AlexanderEkb/Alarm/Art/lv-n104a.jpg

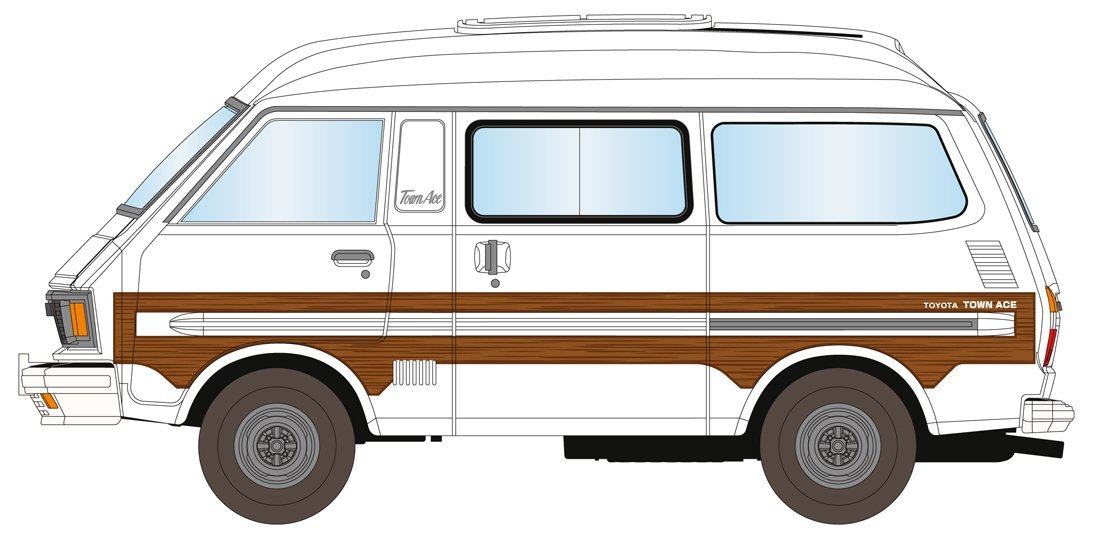
Art/lv-n104a.jpg
