AlexanderEkb/Alarm/Art/2256afcs-960.jpg

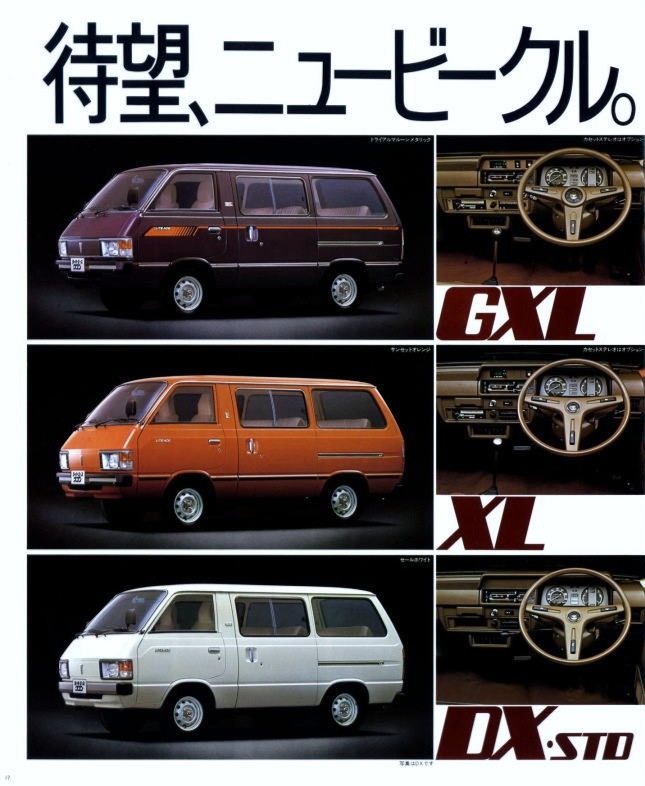
Art/2256afcs-960.jpg
