AlexanderEkb/Alarm/Art/toyota_liteace-26257.jpg

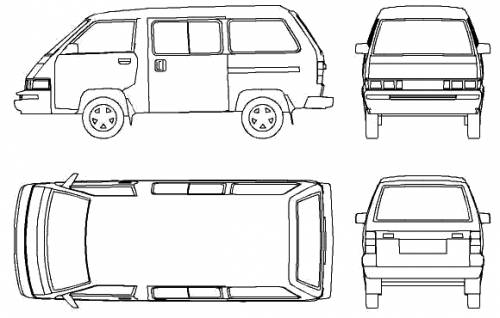
Art/toyota_liteace-26257.jpg
