AlexanderEkb/Alarm/Art/toyota_town_ace_1983-71533.jpg

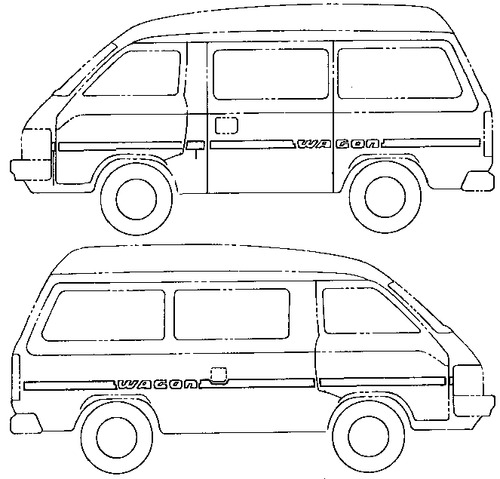
Art/toyota_town_ace_1983-71533.jpg
