AlexanderEkb/Alarm/Art/toyota_townace_van_2014-68481.jpg

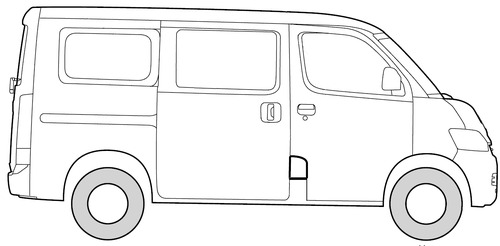
Art/toyota_townace_van_2014-68481.jpg
