AlexanderEkb/Alarm/Base/HW/Project Outputs for Сигнализация/BOM/Bill of Materials-Сигнализация.xls

Sheet: BOM Report
Bill of Materials |  |  | <Parameter Title not found>
Source Data From: |  | Сигнализация.PrjPcb
Project: |  | Сигнализация.PrjPcb
Variant: |  | None
Creation Date: | 11.05.2017 | 8:58:44
Print Date: | 2017-05-11 | 8:58:45
#Column Name Error:Footprint | #Column Name Error:Comment | LibRef | Designator | PartNumber | Quantity
 |  | nRF24L01 + PA + LNA | A1 | nRF24L01+PA+LNA Module | 1
 |  | STM32-1 | A2 | STM32F103 "Blue Pill" Module | 1
 |  | M590E Сборка | A3 | Neoway M590 Assy | 1
 |  | LM2596 Module | A4 | DC-DC Converter Module | 1
 |  | Конденсатор | C1 | T491C227K006AT | 1
 |  | Конденсатор | C2 | T491D477K006AT | 1
 |  | Конденсатор | C3, C4 | CC0603KRX7R7BB104 | 2
 |  | Конденсатор | C5 | CC1206KRX7R9BB104 | 1
 |  | ADM485AR | DD1 | ADM485ARZ-REEL | 1
 |  | TPIC6B595 | DD2 | TPIC6B595DW (SO20W) | 1
 |  | 74HC165 | DD3 | SN74HC165N (DIP16) | 1
 |  | Резистор | R1, R2, R3, R4, R5, R11, R12, R13, R14, R15, R18 |  | 11
 |  | Резистор | R6, R7, R8, R9, R10, R16, R17 | RC1206FR-07100KL | 7
 |  | R0 | RJ6, RJ10, RJ11 | RC1206JR-070RL | 3
 |  | Zener | VD1 | ZMM5226B (ZMM55C-3V3) | 1
 |  | Zener | VD2, VD3, VD4, VD5, VD6, VD7, VD8 | ZMM5229B (ZMM55C-4V3) | 7
 |  | BJT, NPN | VT1 | KSR1002 | 1
 |  | PH-02M(R) | X1, X3 | PH 02MR 2.0mm | 2
 |  | PH-04M(R) | X2 | PH 02M 2.0mm | 1
 |  | MF 2x05 M(R) | X4 | MF 2x05MR | 1
 |  | PH-03M(R) | X5 | PH 02M 2.0mm | 1
 |  | MF 2x03 M(R) | X6 | MF 2x03MR | 1
 |  | PH-04M(R) | X7 | PH 04MR 2.0mm | 1
 |  |  |  |  | 49
Approved |  | Notes

Sheet: Project Information
Project Full Path | D:\Work\Alarm\Base\HW\Ver. 1.1\Сигнализация.PrjPcb
Project Filename | Сигнализация.PrjPcb
Variant Name | None
Data-Source Filename | Сигнализация.PrjPcb
Data-Source Full Path | D:\Work\Alarm\Base\HW\Ver. 1.1\Сигнализация.PrjPcb
Title | <Parameter Title not found>
Total Quantity | 49
Report Time | 8:58:44
Report Date | 11.05.2017
Report Date & Tine | 11.05.2017 8:58:44
Output Name | Bill of Materials
Output Type | BOM_PartType
Output Generator Name | BOM
Output Generator Description | Bill of Materials
