AlexanderEkb/Alarm/FOB/HW/Project Outputs for FOB(3)/BOM/Bill of Materials-FOB(3).xls

Sheet: BOM Report
Bill of Materials |  |  | <Parameter Title not found>
Source Data From: |  | FOB(3).PrjPcb
Project: |  | FOB(3).PrjPcb
Variant: |  | None
Creation Date: | 23.11.2017 | 22:41:56
Print Date: | 2017-11-23 | 22:46:23
Designator | PartNumber |  |  | Quantity
BQ1 | CST-931RP-A |  |  | 1
C1, C2 | CC0402JRNPO9BN220 |  |  | 2
C3 | GRM155R71H222KA01D |  |  | 1
C4 | CC0402BRNPO9BN4R7 |  |  | 1
C5 | CC0402CRNPO9BN1R5 |  |  | 1
C6 | CC0402BRNPO9BNR50 |  |  | 1
C7 | CC0402KRX7R7BB333 |  |  | 1
C8 | CC0402JRNPO9BN102 |  |  | 1
C9 | CC0402KRX7R9BB103 |  |  | 1
C10, C12, C14 | GRM155R61A225KE95D |  |  | 3
C11, C13 | CC0402KRX5R5BB105 |  |  | 2
C15 | GRM155R60J475ME87D |  |  | 1
C16, C18, C19, C20, C21 | CC0402KRX7R7BB104 |  |  | 5
C17 | T491A336K006AT |  |  | 1
DA1 | nRF24L01+ |  |  | 1
DA2 | NCP1400A |  |  | 1
DD1 | STM32F051K8U6 |  |  | 1
GB1, SW1 | Custom |  |  | 2
HG1 | SSD1306 OLED Module |  |  | 1
L1 | LQW15AN8N2G00D |  |  | 1
L2 | LQG15HS27NJ02D |  |  | 1
L3 | LQG15HN3N9S02D |  |  | 1
L4 | VLCF4028T-220MR72-2 |  |  | 1
R1 | RC0402FR-071ML |  |  | 1
R2 | RC0402FR-0722KL |  |  | 1
R3, R4, R6, R7 | RC0402FR-071KL |  |  | 4
R5 | RC0402FR-07390KL |  |  | 1
R8, R9 | RC0402JR-070RL |  |  | 2
VD1 | STPS0520Z |  |  | 1
X1 | PLLD1.27-80 (2X40) SMD |  |  | 1
X2 | PBD1.27-12 (2X06) SMD |  |  | 1
ZQ1 | 16000 KHz HC-49/US |  |  | 1
 |  |  |  | 45
Approved |  | Notes

Sheet: Project Information
Project Full Path | D:\Work\Alarm\FOB\HW\Брелок-3\FOB(3).PrjPcb
Project Filename | FOB(3).PrjPcb
Variant Name | None
Data-Source Filename | FOB(3).PrjPcb
Data-Source Full Path | D:\Work\Alarm\FOB\HW\Брелок-3\FOB(3).PrjPcb
Title | <Parameter Title not found>
Total Quantity | 45
Report Time | 22:41:56
Report Date | 23.11.2017
Report Date & Tine | 23.11.2017 22:41:56
Output Name | Bill of Materials
Output Type | BOM_PartType
Output Generator Name | BOM
Output Generator Description | Bill of Materials
