AlexanderEkb/Alarm/FOB/Enclosure/TopBoard/Top.step

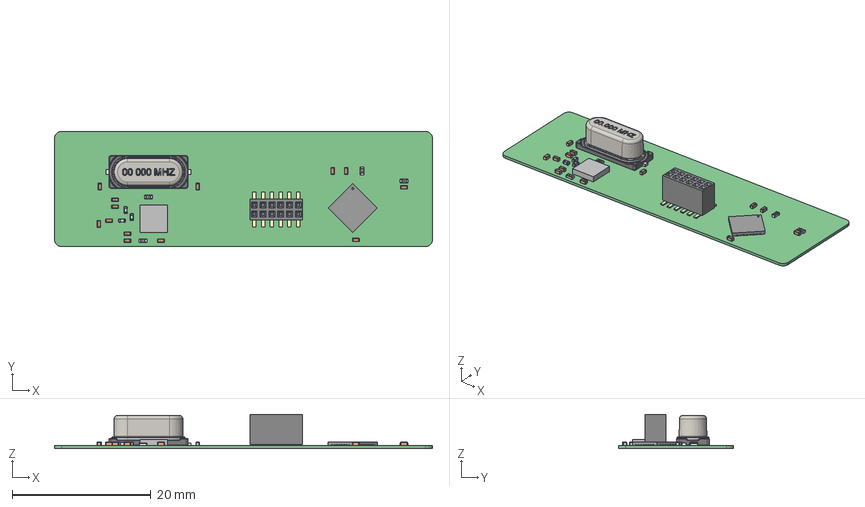
[picture p8: CAD file, 2018-03-03]
FOB/Enclosure/TopBoard/Top.step
54.5 x 16.6 x 4.91 mm
Board
Extruded
User_Library-PBD1_27-12-S
User_Library-UFQFPN32
User_Library-0402(1005M)_Cap x 13
User_Library-RES_1005-0402 x 4
User_Library-HC-49S
User_Library-INDC1005X___ x 3
