AlexanderEkb/Alarm/FOB/HW/Project Outputs for FOB(3)/FOB Schematics.PDF

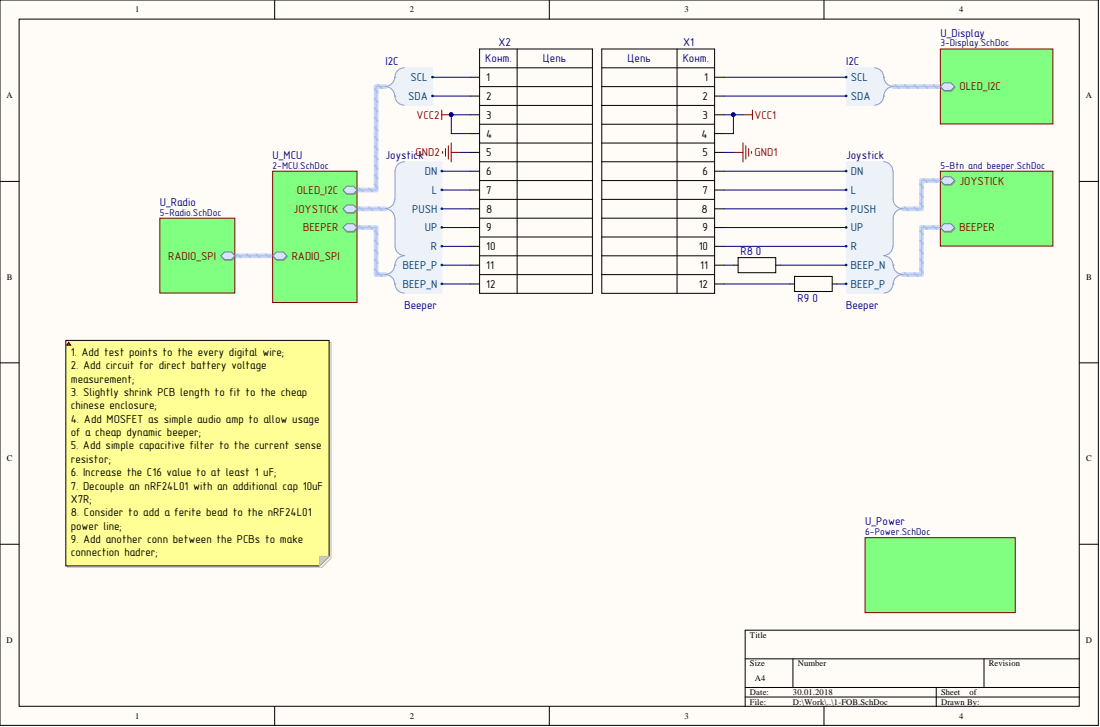
[picture p9: page 1]

5-Btn and beeper.SchDoc
JOYSTICK

1. Add test points to the every digital wire;
2. Add circuit for direct battery voltage
measurement;
3. Slightly shrink PCB length to fit to the cheap
chinese enclosure;
4. Add MOSFET as simple audio amp to allow usage
of a cheap dynamic beeper;
5. Add simple capacitive filter to the current sense
resistor;
6. Increase the C16 value to at least 1 uF;
7. Decouple an nRF24L01 with an additional cap 10uF
8. Consider to add a ferite bead to the nRF24L01
power line;
9. Add another conn between the PCBs to make
connection hadrer;

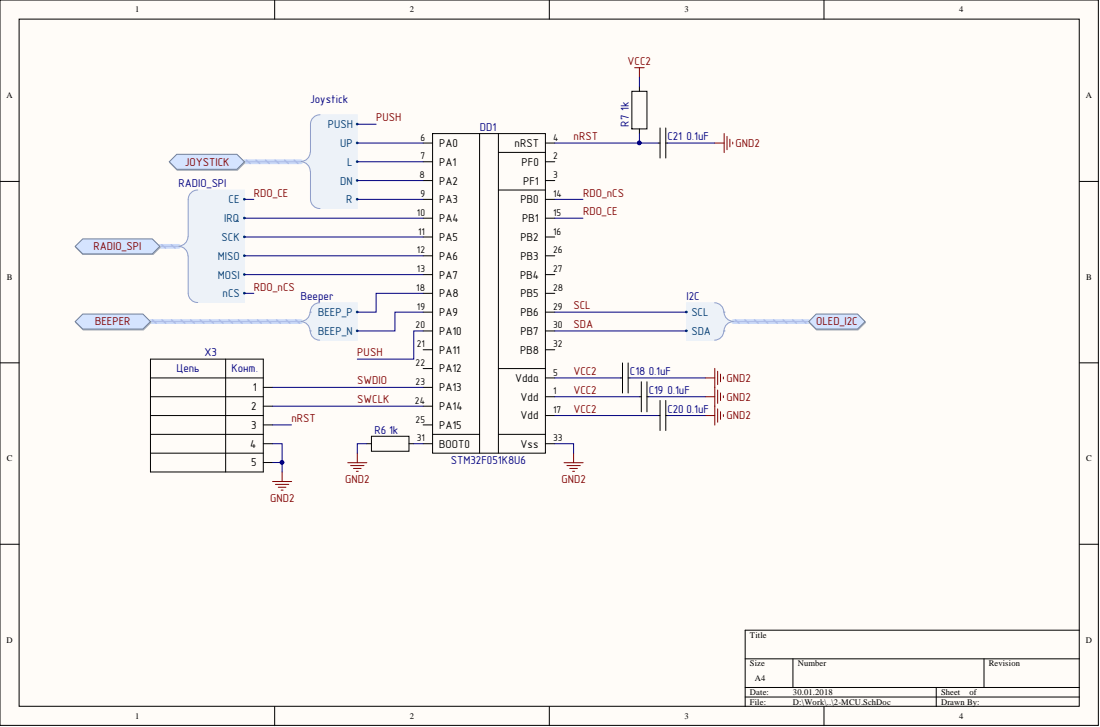
[picture p10: page 2]

PUSH

Цепь | Конт. | SWDIO

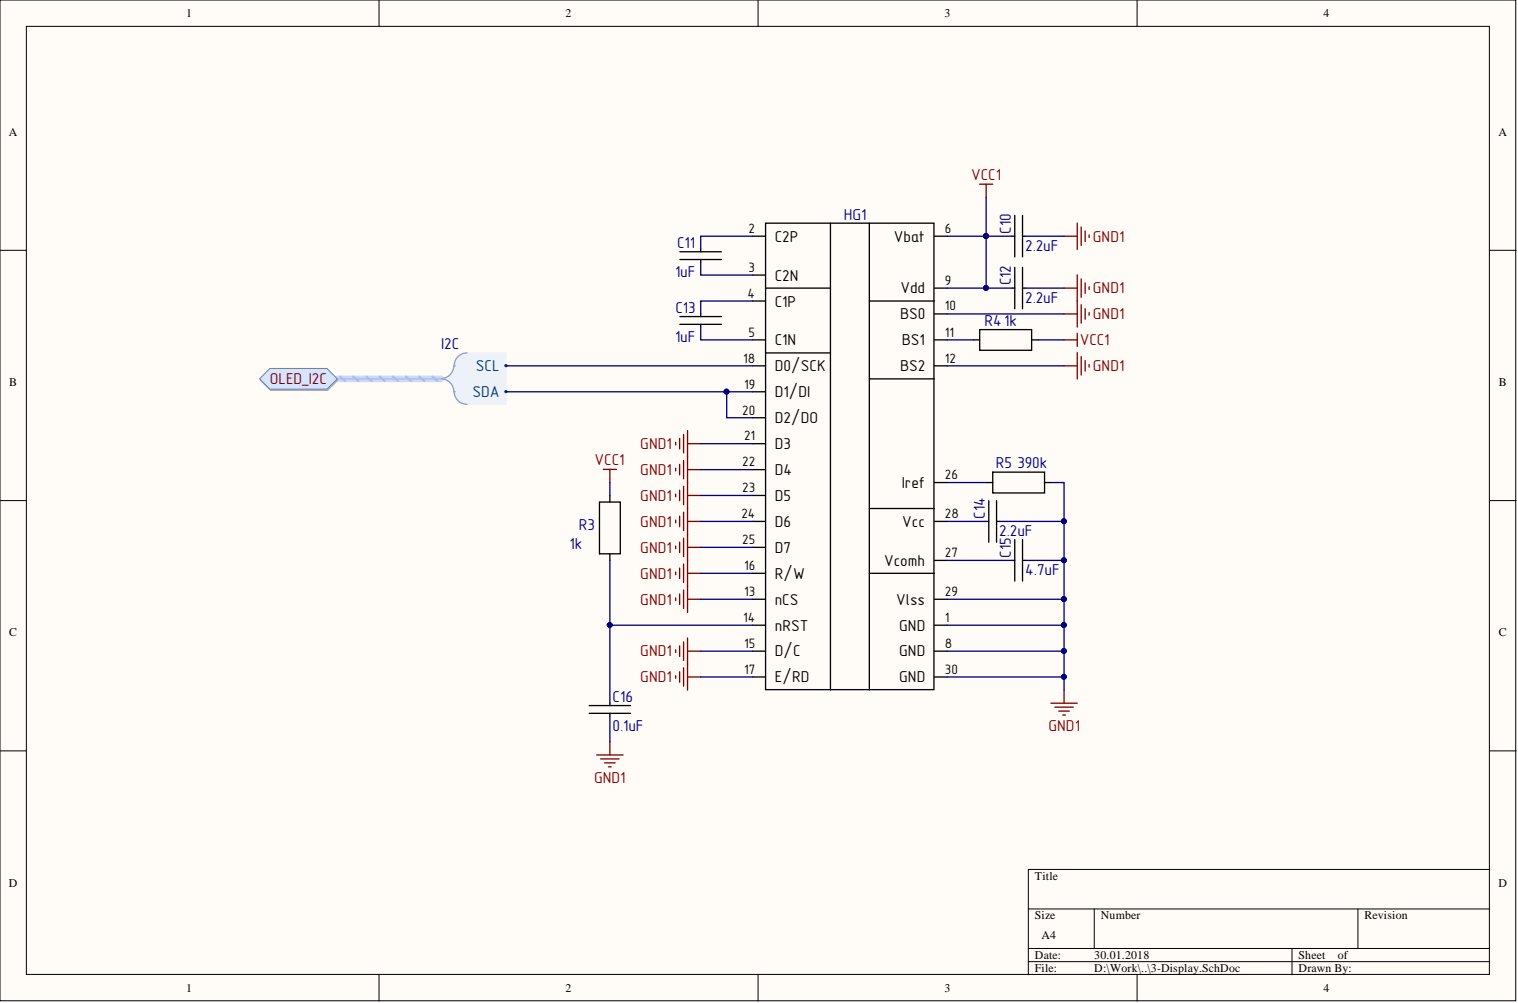
[picture p11: page 3]

C2P C2N | Vbat Vdd

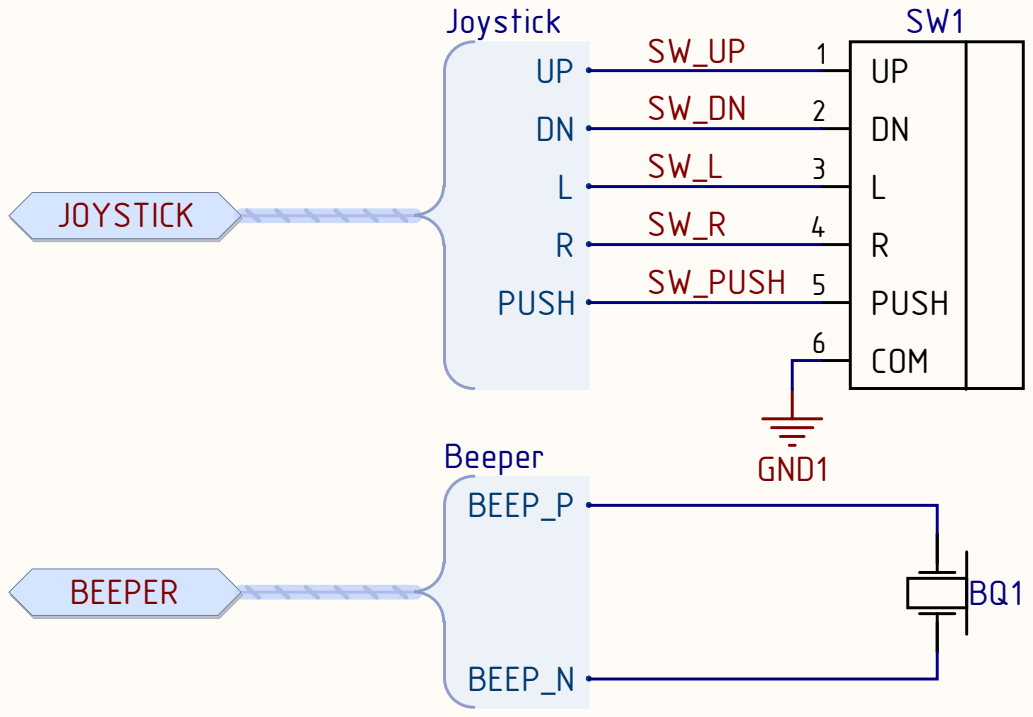
[picture p12: page 4]

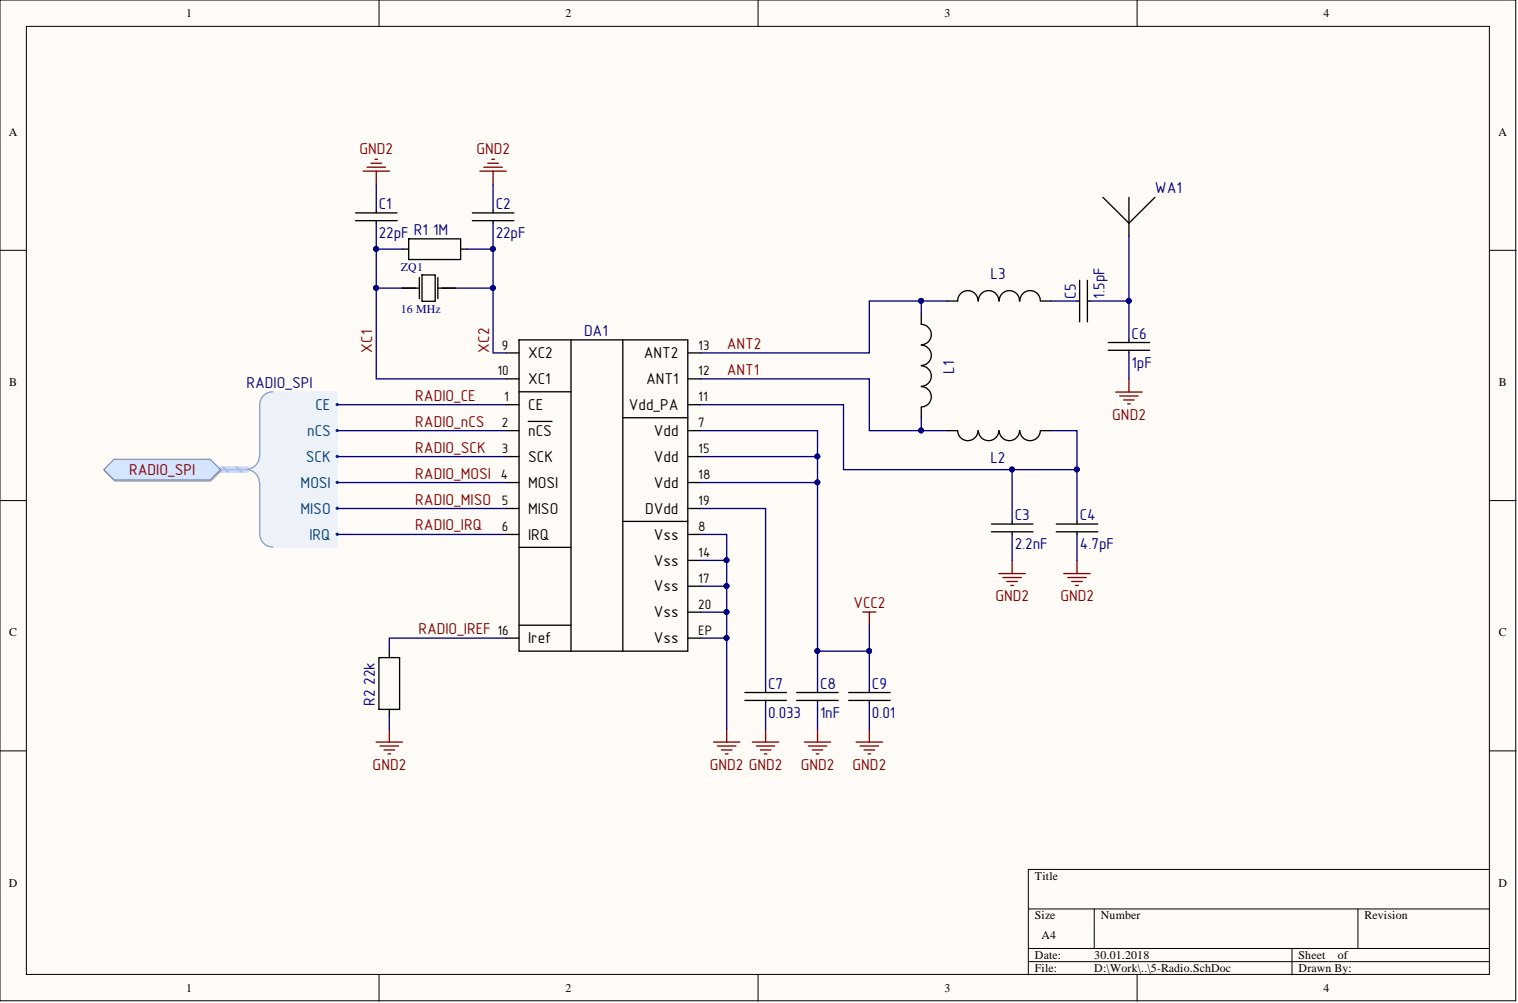
[picture p13: page 5]

1 4
1 7

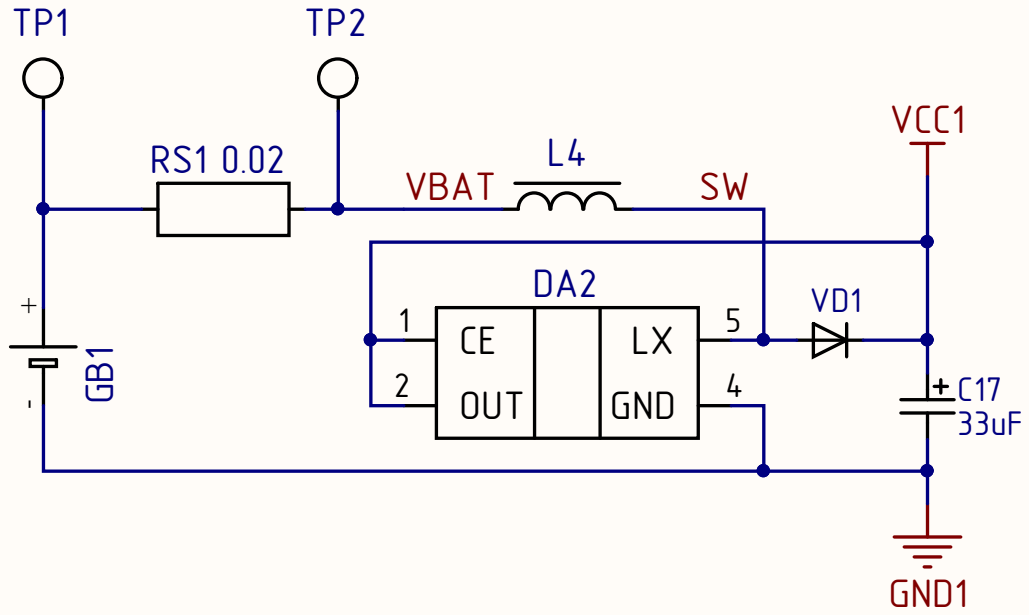
[picture p14: page 6]
