AlexanderEkb/Alarm/Base/HW/Project Outputs for Сигнализация/Основной блок.PDF

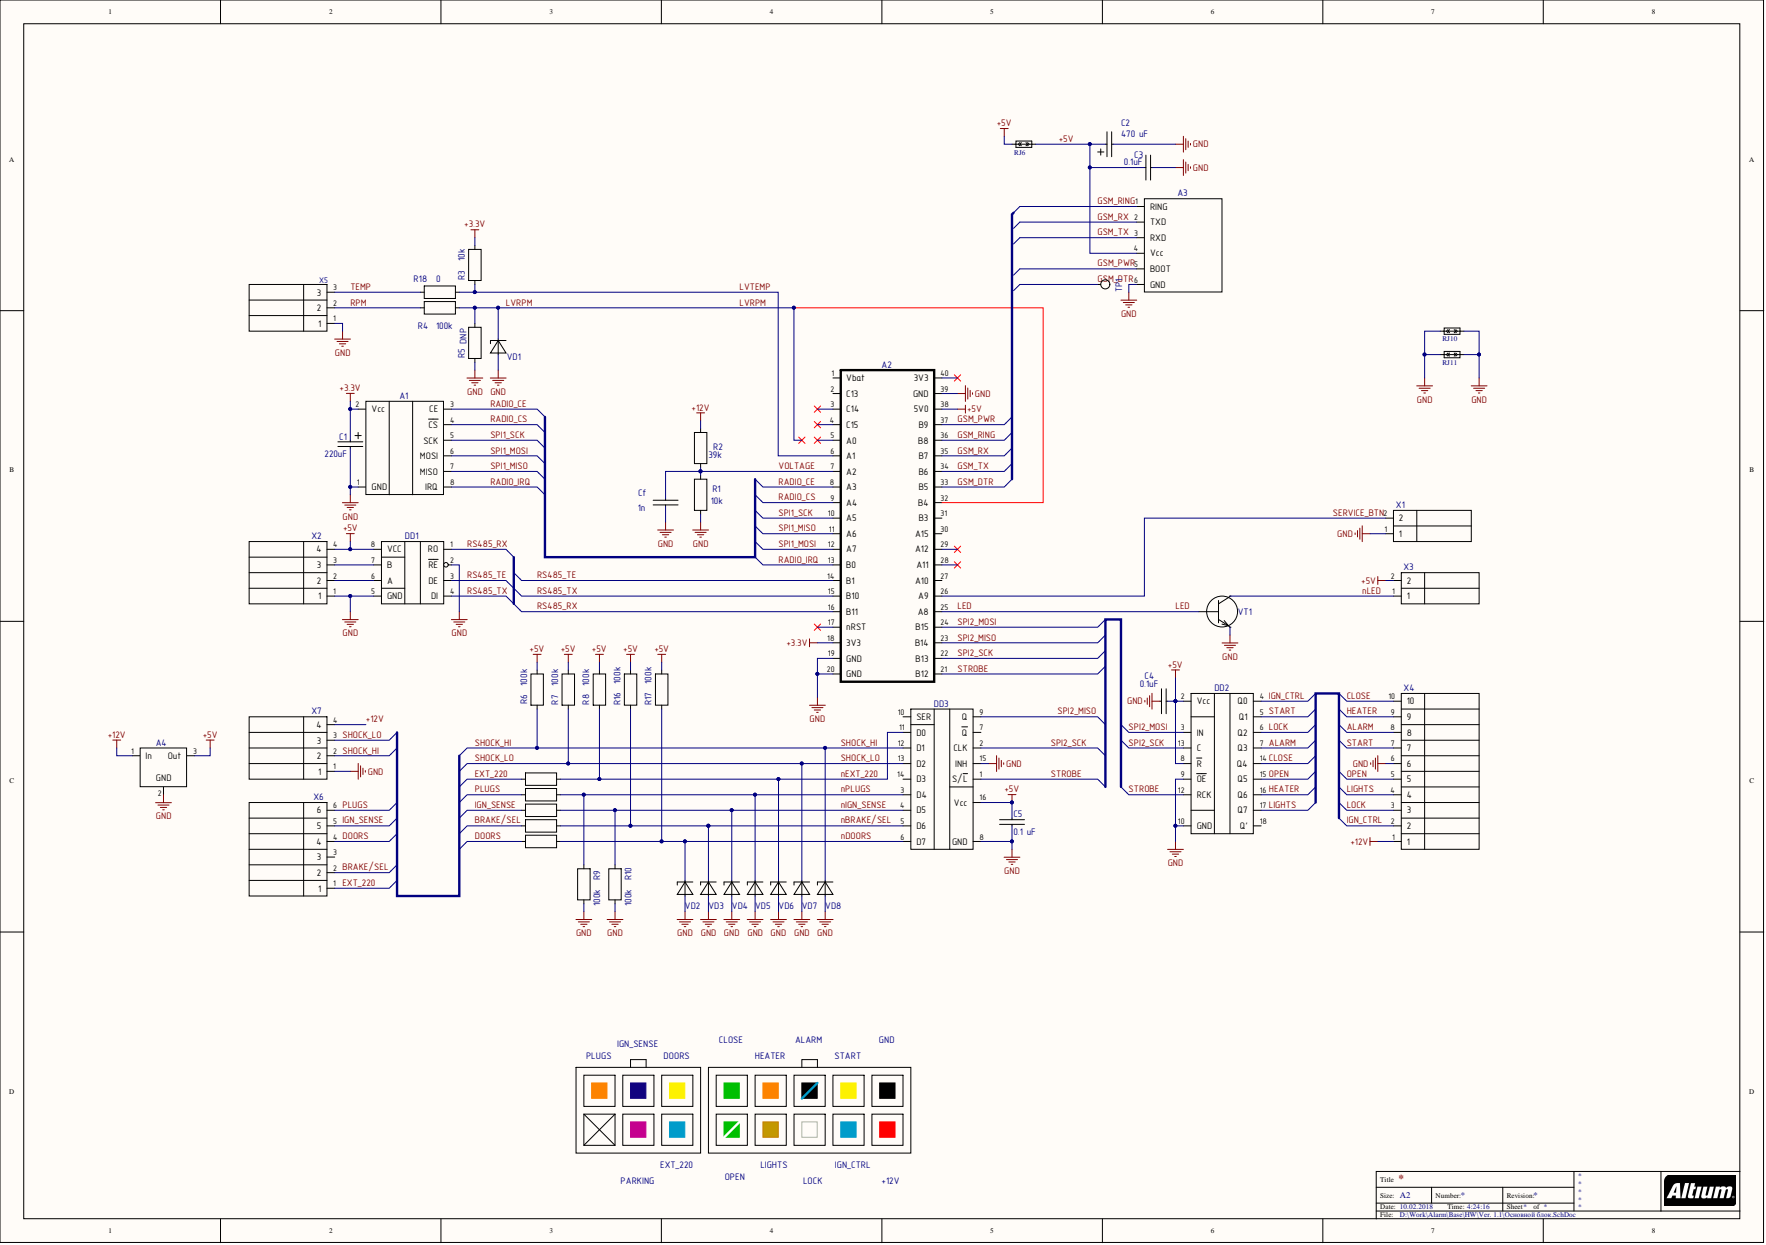
[picture p15: page 1]

1 | RADIO_CE | VD1 +12V | A2

RADIO_CE RADIO_CS

5 5
4 4
3 3

GND GND GND GND GND GND GND

Title * | * * * * *

Size: A2 | Number: * | Revision: *
Date: 10.02.2018 Time: 4:24:16 | | Sheet * of *

D:\Work\Alarm\Base\HW\Ver. 1.1\Основной блок.SchDoc
File:
