AlexanderEkb/Alarm/(list of files, drawings)

Other design files:
Base/HW/Основной блок.SchDoc
Base/HW/Сигнализация.PrjPcb
FOB/HW/1-FOB.SchDoc
FOB/HW/2-MCU.SchDoc
FOB/HW/3-Display.SchDoc
FOB/HW/5-Btn and beeper.SchDoc
FOB/HW/5-Radio.SchDoc
FOB/HW/6-Power.SchDoc
FOB/HW/FOB - lower.PcbDoc
FOB/HW/FOB - upper.PcbDoc
FOB/HW/FOB(3).PrjPcb
Power/Power.PcbDoc
Power/Power.PrjPcb
Power/Power.SchDoc
