AlexanderEkb/Alarm/FOB/SW/FOB_3/Keyfob/Src/main.c

/**
  ******************************************************************************
  * File Name          : main.c
  * Description        : Main program body
  ******************************************************************************
  * This notice applies to any and all portions of this file
  * that are not between comment pairs USER CODE BEGIN and
  * USER CODE END. Other portions of this file, whether
  * inserted by the user or by software development tools
  * are owned by their respective copyright owners.
  *
  * Copyright (c) 2017 STMicroelectronics International N.V.
  * All rights reserved.
  *
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
  ******************************************************************************
  */

/* Includes ------------------------------------------------------------------*/
#include "main.h"
#include "stm32f0xx_hal.h"
#include "cmsis_os.h"

/* USER CODE BEGIN Includes */
#include "power.h"
#include "sound.h"
#include "protocol.h"
#include "radio.h"
#include "ui.h"
#include "dispatcher.h"

/* USER CODE END Includes */


osThreadId RADIOHandle;
osThreadId UIHandle;
osThreadId DISPHandle;
osThreadId SOUNDHandle;

/* USER CODE BEGIN PV */

/* USER CODE END PV */

void SystemClock_Config(void);
static void MX_GPIO_Init(void);
static void MX_I2C1_Init(void);
static void MX_SPI1_Init(void);
static void MX_TIM1_Init(void);
static void MX_ADC_Init(void);
static void MX_RTC_Init(void);
void Radio_Task(void const * argument);
void UI_Task(void const * argument);
static void MX_NVIC_Init(void);

/* USER CODE BEGIN PFP */

/* USER CODE END PFP */

int main(void)
{

    /* USER CODE BEGIN 1 */
    /* Set up low power mode used. */
    MX_GPIO_Init();
    Power_Init();
    /* USER CODE END 1 */

    /* MCU Configuration----------------------------------------------------------*/

    /* Reset of all peripherals, Initializes the Flash interface and the Systick. */
    HAL_Init();

    /* Configure the system clock */
    SystemClock_Config();

    /* USER CODE BEGIN SysInit */

    PWR->CR |= PWR_CR_DBP;
    RCC->CSR |= RCC_CSR_LSION;

    /* USER CODE END SysInit */

    /* Initialize all configured peripherals */
//    MX_GPIO_Init();
    MX_I2C1_Init();
    MX_SPI1_Init();
    MX_TIM1_Init();
    MX_ADC_Init();
    MX_RTC_Init();

    /* Initialize interrupts */
    MX_NVIC_Init();

    /* USER CODE BEGIN 2 */
    Power_InitSettings(0, 0);
    Radio_Init();
    Sound_Init();
    Power_InitIWDG();
    /* USER CODE END 2 */

    /* USER CODE BEGIN RTOS_MUTEX */
    /* add mutexes, ... */
    /* USER CODE END RTOS_MUTEX */

    /* USER CODE BEGIN RTOS_SEMAPHORES */
    /* add semaphores, ... */
    /* USER CODE END RTOS_SEMAPHORES */

    /* USER CODE BEGIN RTOS_TIMERS */
    /* start timers, add new ones, ... */
    /* USER CODE END RTOS_TIMERS */

    /* Create the thread(s) */
    /* definition and creation of RADIO */
    osThreadDef(RADIO, Radio_Task, osPriorityRealtime, 0, 256);
    RADIOHandle = osThreadCreate(osThread(RADIO), NULL);

    /* definition and creation of UI */
    osThreadDef(UI, UI_Task, osPriorityBelowNormal, 0, 256);
    UIHandle = osThreadCreate(osThread(UI), NULL);

    /* definition and creation of DISPATCHER */
    osThreadDef(DISP, Dispatcher_Task, osPriorityLow, 0, 256);
    DISPHandle = osThreadCreate(osThread(DISP), NULL);

    /* definition and creation of SOUND */
    osThreadDef(SOUND, Sound_Task, osPriorityNormal, 0, 128);
    SOUNDHandle = osThreadCreate(osThread(SOUND), NULL);

    /* USER CODE BEGIN RTOS_THREADS */
    /* add threads, ... */
    /* USER CODE END RTOS_THREADS */

    /* USER CODE BEGIN RTOS_QUEUES */
    UI_Init();
    /* USER CODE END RTOS_QUEUES */


    /* Start scheduler */
    osKernelStart();

    /* We should never get here as control is now taken by the scheduler */

    /* Infinite loop */
    /* USER CODE BEGIN WHILE */
    while (1)
    {
    /* USER CODE END WHILE */

    /* USER CODE BEGIN 3 */
        vTaskDelay(1);
    }
    /* USER CODE END 3 */

}

/** System Clock Configuration
*/
void SystemClock_Config(void)
{

  LL_FLASH_SetLatency(LL_FLASH_LATENCY_0);

  if(LL_FLASH_GetLatency() != LL_FLASH_LATENCY_0)
  {
  Error_Handler();
  }
  LL_RCC_HSI_Enable();

   /* Wait till HSI is ready */
  while(LL_RCC_HSI_IsReady() != 1)
  {

  }
  LL_RCC_HSI_SetCalibTrimming(16);

  LL_RCC_HSI14_Enable();

   /* Wait till HSI14 is ready */
  while(LL_RCC_HSI14_IsReady() != 1)
  {

  }
  LL_RCC_HSI14_SetCalibTrimming(16);

  LL_RCC_LSI_Enable();

   /* Wait till LSI is ready */
  while(LL_RCC_LSI_IsReady() != 1)
  {

  }
  LL_PWR_EnableBkUpAccess();

  //LL_RCC_ForceBackupDomainReset();

  //LL_RCC_ReleaseBackupDomainReset();

  LL_RCC_SetRTCClockSource(LL_RCC_RTC_CLKSOURCE_LSI);

  LL_RCC_EnableRTC();

  LL_RCC_SetAHBPrescaler(LL_RCC_SYSCLK_DIV_1);

  LL_RCC_SetAPB1Prescaler(LL_RCC_APB1_DIV_1);

  LL_RCC_SetSysClkSource(LL_RCC_SYS_CLKSOURCE_HSI);

   /* Wait till System clock is ready */
  while(LL_RCC_GetSysClkSource() != LL_RCC_SYS_CLKSOURCE_STATUS_HSI)
  {

  }
  LL_Init1msTick(8000000);

  LL_SYSTICK_SetClkSource(LL_SYSTICK_CLKSOURCE_HCLK);

  LL_SetSystemCoreClock(8000000);

  LL_RCC_HSI14_EnableADCControl();

  LL_RCC_SetI2CClockSource(LL_RCC_I2C1_CLKSOURCE_SYSCLK);

  /* SysTick_IRQn interrupt configuration */
  NVIC_SetPriority(SysTick_IRQn, 3);
}

/** NVIC Configuration
*/
static void MX_NVIC_Init(void)
{
  /* SPI1_IRQn interrupt configuration */
  NVIC_SetPriority(SPI1_IRQn, 3);
  NVIC_EnableIRQ(SPI1_IRQn);
  /* EXTI4_15_IRQn interrupt configuration */
  NVIC_SetPriority(EXTI4_15_IRQn, 3);
  NVIC_EnableIRQ(EXTI4_15_IRQn);
  /* EXTI0_1_IRQn interrupt configuration */
  NVIC_SetPriority(EXTI0_1_IRQn, 3);
  NVIC_EnableIRQ(EXTI0_1_IRQn);
  /* EXTI2_3_IRQn interrupt configuration */
  NVIC_SetPriority(EXTI2_3_IRQn, 3);
  NVIC_EnableIRQ(EXTI2_3_IRQn);
}

/* ADC init function */
static void MX_ADC_Init(void)
{

  LL_ADC_InitTypeDef ADC_InitStruct;
  LL_ADC_REG_InitTypeDef ADC_REG_InitStruct;

  /* Peripheral clock enable */
  LL_APB1_GRP2_EnableClock(LL_APB1_GRP2_PERIPH_ADC1);

    /**Configure Regular Channel
    */
  LL_ADC_REG_SetSequencerChannels(ADC1, LL_ADC_CHANNEL_VBAT);

  LL_ADC_SetCommonPathInternalCh(__LL_ADC_COMMON_INSTANCE(ADC1), LL_ADC_PATH_INTERNAL_VBAT);

    /**Configure the global features of the ADC (Clock, Resolution, Data Alignment and number of conversion)
    */
  ADC_InitStruct.Resolution = LL_ADC_RESOLUTION_12B;
  ADC_InitStruct.DataAlignment = LL_ADC_DATA_ALIGN_RIGHT;
  ADC_InitStruct.LowPowerMode = LL_ADC_LP_MODE_NONE;
  LL_ADC_Init(ADC1, &ADC_InitStruct);

  LL_ADC_SetClock(ADC1, LL_ADC_CLOCK_ASYNC);

  ADC_REG_InitStruct.TriggerSource = LL_ADC_REG_TRIG_SOFTWARE;
  ADC_REG_InitStruct.SequencerDiscont = LL_ADC_REG_SEQ_DISCONT_DISABLE;
  ADC_REG_InitStruct.ContinuousMode = LL_ADC_REG_CONV_SINGLE;
  ADC_REG_InitStruct.DMATransfer = LL_ADC_REG_DMA_TRANSFER_LIMITED;
  ADC_REG_InitStruct.Overrun = LL_ADC_REG_OVR_DATA_PRESERVED;
  LL_ADC_REG_Init(ADC1, &ADC_REG_InitStruct);

  LL_ADC_REG_SetSequencerScanDirection(ADC1, LL_ADC_REG_SEQ_SCAN_DIR_FORWARD);

  LL_ADC_SetSamplingTimeCommonChannels(ADC1, LL_ADC_SAMPLINGTIME_1CYCLE_5);

  LL_ADC_EnableIT_EOC(ADC1);

  LL_ADC_DisableIT_EOS(ADC1);

}

/* I2C1 init function */
static void MX_I2C1_Init(void)
{

  LL_I2C_InitTypeDef I2C_InitStruct;

  LL_GPIO_InitTypeDef GPIO_InitStruct;

  /**I2C1 GPIO Configuration
  PB6   ------> I2C1_SCL
  PB7   ------> I2C1_SDA
  */
  GPIO_InitStruct.Pin = LL_GPIO_PIN_6;
  GPIO_InitStruct.Mode = LL_GPIO_MODE_ALTERNATE;
  GPIO_InitStruct.Speed = LL_GPIO_SPEED_FREQ_LOW;
  GPIO_InitStruct.OutputType = LL_GPIO_OUTPUT_OPENDRAIN;
  GPIO_InitStruct.Pull = LL_GPIO_PULL_UP;
  GPIO_InitStruct.Alternate = LL_GPIO_AF_1;
  LL_GPIO_Init(GPIOB, &GPIO_InitStruct);

  GPIO_InitStruct.Pin = LL_GPIO_PIN_7;
  GPIO_InitStruct.Mode = LL_GPIO_MODE_ALTERNATE;
  GPIO_InitStruct.Speed = LL_GPIO_SPEED_FREQ_LOW;
  GPIO_InitStruct.OutputType = LL_GPIO_OUTPUT_OPENDRAIN;
  GPIO_InitStruct.Pull = LL_GPIO_PULL_UP;
  GPIO_InitStruct.Alternate = LL_GPIO_AF_1;
  LL_GPIO_Init(GPIOB, &GPIO_InitStruct);

  /* Peripheral clock enable */
  LL_APB1_GRP1_EnableClock(LL_APB1_GRP1_PERIPH_I2C1);

    /**I2C Initialization
    */
  I2C_InitStruct.PeripheralMode = LL_I2C_MODE_I2C;
  I2C_InitStruct.Timing = 0x00000102;
  I2C_InitStruct.AnalogFilter = LL_I2C_ANALOGFILTER_ENABLE;
  I2C_InitStruct.DigitalFilter = 0;
  I2C_InitStruct.OwnAddress1 = 120;
  I2C_InitStruct.TypeAcknowledge = LL_I2C_ACK;
  I2C_InitStruct.OwnAddrSize = LL_I2C_OWNADDRESS1_7BIT;
  LL_I2C_Init(I2C1, &I2C_InitStruct);

  LL_I2C_EnableAutoEndMode(I2C1);

  LL_I2C_SetOwnAddress2(I2C1, 0, LL_I2C_OWNADDRESS2_NOMASK);

  LL_I2C_DisableOwnAddress2(I2C1);

  LL_I2C_DisableGeneralCall(I2C1);

  LL_I2C_EnableClockStretching(I2C1);

}

/* RTC init function */
static void MX_RTC_Init(void)
{

  LL_RTC_InitTypeDef RTC_InitStruct;
  LL_RTC_TimeTypeDef RTC_TimeStruct;
  LL_RTC_DateTypeDef RTC_DateStruct;

  /* Peripheral clock enable */
  LL_RCC_EnableRTC();
  LL_RCC_SetRTCClockSource(LL_RCC_RTC_CLKSOURCE_LSI);


    /**Initialize RTC and set the Time and Date
    */
  RTC_InitStruct.HourFormat = LL_RTC_HOURFORMAT_24HOUR;
  RTC_InitStruct.AsynchPrescaler = 127;
  RTC_InitStruct.SynchPrescaler = 255;
  LL_RTC_Init(RTC, &RTC_InitStruct);

  LL_RTC_SetAsynchPrescaler(RTC, 127);

  LL_RTC_SetSynchPrescaler(RTC, 255);

    /**Initialize RTC and set the Time and Date
    */

  if(LL_RTC_BAK_GetRegister(RTC, LL_RTC_BKP_DR0) != 0x32F2){
//  if(Power_IfPOR()){

  RTC_TimeStruct.Hours = 0;
  RTC_TimeStruct.Minutes = 0x12;
  RTC_TimeStruct.Seconds = 0x34;
  LL_RTC_TIME_Init(RTC, LL_RTC_FORMAT_BCD, &RTC_TimeStruct);

  RTC_DateStruct.WeekDay = LL_RTC_WEEKDAY_MONDAY;
  RTC_DateStruct.Month = LL_RTC_MONTH_JANUARY;
  RTC_DateStruct.Year = 0;
  LL_RTC_DATE_Init(RTC, LL_RTC_FORMAT_BCD, &RTC_DateStruct);

  LL_RTC_BAK_SetRegister(RTC,LL_RTC_BKP_DR0,0x32F2);
  }
}

/* SPI1 init function */
static void MX_SPI1_Init(void)
{

  LL_SPI_InitTypeDef SPI_InitStruct;

  LL_GPIO_InitTypeDef GPIO_InitStruct;

  /* Peripheral clock enable */
  LL_APB1_GRP2_EnableClock(LL_APB1_GRP2_PERIPH_SPI1);

  /**SPI1 GPIO Configuration
  PA5   ------> SPI1_SCK
  PA6   ------> SPI1_MISO
  PA7   ------> SPI1_MOSI
  */
  GPIO_InitStruct.Pin = LL_GPIO_PIN_5;
  GPIO_InitStruct.Mode = LL_GPIO_MODE_ALTERNATE;
  GPIO_InitStruct.Speed = LL_GPIO_SPEED_FREQ_HIGH;
  GPIO_InitStruct.OutputType = LL_GPIO_OUTPUT_PUSHPULL;
  GPIO_InitStruct.Pull = LL_GPIO_PULL_NO;
  GPIO_InitStruct.Alternate = LL_GPIO_AF_0;
  LL_GPIO_Init(GPIOA, &GPIO_InitStruct);

  GPIO_InitStruct.Pin = LL_GPIO_PIN_6;
  GPIO_InitStruct.Mode = LL_GPIO_MODE_ALTERNATE;
  GPIO_InitStruct.Speed = LL_GPIO_SPEED_FREQ_HIGH;
  GPIO_InitStruct.OutputType = LL_GPIO_OUTPUT_PUSHPULL;
  GPIO_InitStruct.Pull = LL_GPIO_PULL_NO;
  GPIO_InitStruct.Alternate = LL_GPIO_AF_0;
  LL_GPIO_Init(GPIOA, &GPIO_InitStruct);

  GPIO_InitStruct.Pin = LL_GPIO_PIN_7;
  GPIO_InitStruct.Mode = LL_GPIO_MODE_ALTERNATE;
  GPIO_InitStruct.Speed = LL_GPIO_SPEED_FREQ_HIGH;
  GPIO_InitStruct.OutputType = LL_GPIO_OUTPUT_PUSHPULL;
  GPIO_InitStruct.Pull = LL_GPIO_PULL_NO;
  GPIO_InitStruct.Alternate = LL_GPIO_AF_0;
  LL_GPIO_Init(GPIOA, &GPIO_InitStruct);

  /* SPI1 parameter configuration*/
  SPI_InitStruct.TransferDirection = LL_SPI_FULL_DUPLEX;
  SPI_InitStruct.Mode = LL_SPI_MODE_MASTER;
  SPI_InitStruct.DataWidth = LL_SPI_DATAWIDTH_8BIT;
  SPI_InitStruct.ClockPolarity = LL_SPI_POLARITY_LOW;
  SPI_InitStruct.ClockPhase = LL_SPI_PHASE_1EDGE;
  SPI_InitStruct.NSS = LL_SPI_NSS_SOFT;
  SPI_InitStruct.BaudRate = LL_SPI_BAUDRATEPRESCALER_DIV2;
  SPI_InitStruct.BitOrder = LL_SPI_MSB_FIRST;
  SPI_InitStruct.CRCCalculation = LL_SPI_CRCCALCULATION_DISABLE;
  SPI_InitStruct.CRCPoly = 7;
  LL_SPI_Init(SPI1, &SPI_InitStruct);

  LL_SPI_SetStandard(SPI1, LL_SPI_PROTOCOL_MOTOROLA);

  LL_SPI_DisableNSSPulseMgt(SPI1);

}

/* TIM1 init function */
static void MX_TIM1_Init(void)
{

  LL_TIM_InitTypeDef TIM_InitStruct;
  LL_TIM_OC_InitTypeDef TIM_OC_InitStruct;
  LL_TIM_BDTR_InitTypeDef TIM_BDTRInitStruct;

  LL_GPIO_InitTypeDef GPIO_InitStruct;

  /* Peripheral clock enable */
  LL_APB1_GRP2_EnableClock(LL_APB1_GRP2_PERIPH_TIM1);

  TIM_InitStruct.Prescaler = 1000;
  TIM_InitStruct.CounterMode = LL_TIM_COUNTERMODE_UP;
  TIM_InitStruct.Autoreload = 0;
  TIM_InitStruct.ClockDivision = LL_TIM_CLOCKDIVISION_DIV1;
  TIM_InitStruct.RepetitionCounter = 48;
  LL_TIM_Init(TIM1, &TIM_InitStruct);

  LL_TIM_DisableARRPreload(TIM1);

  LL_TIM_SetClockSource(TIM1, LL_TIM_CLOCKSOURCE_INTERNAL);

  TIM_OC_InitStruct.OCMode = LL_TIM_OCMODE_ACTIVE;
  TIM_OC_InitStruct.OCState = LL_TIM_OCSTATE_DISABLE;
  TIM_OC_InitStruct.OCNState = LL_TIM_OCSTATE_DISABLE;
  TIM_OC_InitStruct.CompareValue = 24;
  TIM_OC_InitStruct.OCPolarity = LL_TIM_OCPOLARITY_HIGH;
  TIM_OC_InitStruct.OCNPolarity = LL_TIM_OCPOLARITY_HIGH;
  TIM_OC_InitStruct.OCIdleState = LL_TIM_OCIDLESTATE_LOW;
  TIM_OC_InitStruct.OCNIdleState = LL_TIM_OCIDLESTATE_LOW;
  LL_TIM_OC_Init(TIM1, LL_TIM_CHANNEL_CH1, &TIM_OC_InitStruct);

  LL_TIM_OC_DisableFast(TIM1, LL_TIM_CHANNEL_CH1);

  TIM_OC_InitStruct.OCState = LL_TIM_OCSTATE_DISABLE;
  TIM_OC_InitStruct.OCNState = LL_TIM_OCSTATE_DISABLE;
  TIM_OC_InitStruct.OCPolarity = LL_TIM_OCPOLARITY_LOW;
  TIM_OC_InitStruct.OCIdleState = LL_TIM_OCIDLESTATE_HIGH;
  LL_TIM_OC_Init(TIM1, LL_TIM_CHANNEL_CH2, &TIM_OC_InitStruct);

  LL_TIM_OC_DisableFast(TIM1, LL_TIM_CHANNEL_CH2);

  LL_TIM_SetTriggerOutput(TIM1, LL_TIM_TRGO_RESET);

  LL_TIM_DisableMasterSlaveMode(TIM1);

  TIM_BDTRInitStruct.OSSRState = LL_TIM_OSSR_DISABLE;
  TIM_BDTRInitStruct.OSSIState = LL_TIM_OSSI_DISABLE;
  TIM_BDTRInitStruct.LockLevel = LL_TIM_LOCKLEVEL_OFF;
  TIM_BDTRInitStruct.DeadTime = 0;
  TIM_BDTRInitStruct.BreakState = LL_TIM_BREAK_DISABLE;
  TIM_BDTRInitStruct.BreakPolarity = LL_TIM_BREAK_POLARITY_HIGH;
  TIM_BDTRInitStruct.AutomaticOutput = LL_TIM_AUTOMATICOUTPUT_DISABLE;
  LL_TIM_BDTR_Init(TIM1, &TIM_BDTRInitStruct);

  /**TIM1 GPIO Configuration
  PA8   ------> TIM1_CH1
  PA9   ------> TIM1_CH2
  */
  GPIO_InitStruct.Pin = LL_GPIO_PIN_8;
  GPIO_InitStruct.Mode = LL_GPIO_MODE_INPUT; //LL_GPIO_MODE_ALTERNATE;
  GPIO_InitStruct.Speed = LL_GPIO_SPEED_FREQ_LOW;
  GPIO_InitStruct.OutputType = LL_GPIO_OUTPUT_PUSHPULL;
  GPIO_InitStruct.Pull = LL_GPIO_PULL_NO;
  GPIO_InitStruct.Alternate = LL_GPIO_AF_2;
  LL_GPIO_Init(GPIOA, &GPIO_InitStruct);

  GPIO_InitStruct.Pin = LL_GPIO_PIN_9;
  GPIO_InitStruct.Mode = LL_GPIO_MODE_INPUT; //LL_GPIO_MODE_ALTERNATE;
  GPIO_InitStruct.Speed = LL_GPIO_SPEED_FREQ_LOW;
  GPIO_InitStruct.OutputType = LL_GPIO_OUTPUT_PUSHPULL;
  GPIO_InitStruct.Pull = LL_GPIO_PULL_NO;
  GPIO_InitStruct.Alternate = LL_GPIO_AF_2;
  LL_GPIO_Init(GPIOA, &GPIO_InitStruct);

}

/** Configure pins as
        * Analog
        * Input
        * Output
        * EVENT_OUT
        * EXTI
*/
static void MX_GPIO_Init(void)
{

  LL_GPIO_InitTypeDef GPIO_InitStruct;
  LL_EXTI_InitTypeDef EXTI_InitStruct;

  /* GPIO Ports Clock Enable */
  LL_AHB1_GRP1_EnableClock(LL_AHB1_GRP1_PERIPH_GPIOA);
  LL_AHB1_GRP1_EnableClock(LL_AHB1_GRP1_PERIPH_GPIOB);
  LL_AHB1_GRP1_EnableClock(LL_AHB1_GRP1_PERIPH_GPIOF);
  GPIOF->MODER = 0x55555555;


  /**/
  GPIO_InitStruct.Pin = LL_GPIO_PIN_0;
  GPIO_InitStruct.Mode = LL_GPIO_MODE_OUTPUT;
  GPIO_InitStruct.Speed = LL_GPIO_SPEED_FREQ_LOW;
  GPIO_InitStruct.OutputType = LL_GPIO_OUTPUT_PUSHPULL;
  GPIO_InitStruct.Pull = LL_GPIO_PULL_NO;
  LL_GPIO_Init(GPIOB, &GPIO_InitStruct);

  /**/
  GPIO_InitStruct.Pin = LL_GPIO_PIN_1;
  GPIO_InitStruct.Mode = LL_GPIO_MODE_OUTPUT;
  GPIO_InitStruct.Speed = LL_GPIO_SPEED_FREQ_LOW;
  GPIO_InitStruct.OutputType = LL_GPIO_OUTPUT_PUSHPULL;
  GPIO_InitStruct.Pull = LL_GPIO_PULL_NO;
  LL_GPIO_Init(GPIOB, &GPIO_InitStruct);

  /**/
  LL_GPIO_SetOutputPin(GPIOB, LL_GPIO_PIN_0);

  /**/
  LL_GPIO_ResetOutputPin(GPIOB, LL_GPIO_PIN_1);

  /**/
  LL_SYSCFG_SetEXTISource(LL_SYSCFG_EXTI_PORTA, LL_SYSCFG_EXTI_LINE0);

  /**/
  LL_SYSCFG_SetEXTISource(LL_SYSCFG_EXTI_PORTA, LL_SYSCFG_EXTI_LINE1);

  /**/
  LL_SYSCFG_SetEXTISource(LL_SYSCFG_EXTI_PORTA, LL_SYSCFG_EXTI_LINE2);

  /**/
  LL_SYSCFG_SetEXTISource(LL_SYSCFG_EXTI_PORTA, LL_SYSCFG_EXTI_LINE3);

  /**/
  LL_SYSCFG_SetEXTISource(LL_SYSCFG_EXTI_PORTA, LL_SYSCFG_EXTI_LINE4);

  /**/
  LL_SYSCFG_SetEXTISource(LL_SYSCFG_EXTI_PORTA, LL_SYSCFG_EXTI_LINE10);

  /**/
  LL_GPIO_SetPinPull(GPIOA, LL_GPIO_PIN_0, LL_GPIO_PULL_UP);

  /**/
  LL_GPIO_SetPinPull(GPIOA, LL_GPIO_PIN_1, LL_GPIO_PULL_UP);

  /**/
  LL_GPIO_SetPinPull(GPIOA, LL_GPIO_PIN_2, LL_GPIO_PULL_UP);

  /**/
  LL_GPIO_SetPinPull(GPIOA, LL_GPIO_PIN_3, LL_GPIO_PULL_UP);

  /**/
  LL_GPIO_SetPinPull(GPIOA, LL_GPIO_PIN_4, LL_GPIO_PULL_NO);

  /**/
  LL_GPIO_SetPinPull(GPIOA, LL_GPIO_PIN_10, LL_GPIO_PULL_UP);

  /**/
  LL_GPIO_SetPinMode(GPIOA, LL_GPIO_PIN_0, LL_GPIO_MODE_INPUT);

  /**/
  LL_GPIO_SetPinMode(GPIOA, LL_GPIO_PIN_1, LL_GPIO_MODE_INPUT);

  /**/
  LL_GPIO_SetPinMode(GPIOA, LL_GPIO_PIN_2, LL_GPIO_MODE_INPUT);

  /**/
  LL_GPIO_SetPinMode(GPIOA, LL_GPIO_PIN_3, LL_GPIO_MODE_INPUT);

  /**/
  LL_GPIO_SetPinMode(GPIOA, LL_GPIO_PIN_4, LL_GPIO_MODE_INPUT);

  /**/
  LL_GPIO_SetPinMode(GPIOA, LL_GPIO_PIN_10, LL_GPIO_MODE_INPUT);

  /**/
  EXTI_InitStruct.Line_0_31 = LL_EXTI_LINE_0;
  EXTI_InitStruct.LineCommand = ENABLE;
  EXTI_InitStruct.Mode = LL_EXTI_MODE_IT;
  EXTI_InitStruct.Trigger = LL_EXTI_TRIGGER_FALLING;
  LL_EXTI_Init(&EXTI_InitStruct);

  /**/
  EXTI_InitStruct.Line_0_31 = LL_EXTI_LINE_1;
  EXTI_InitStruct.LineCommand = ENABLE;
  EXTI_InitStruct.Mode = LL_EXTI_MODE_IT;
  EXTI_InitStruct.Trigger = LL_EXTI_TRIGGER_FALLING;
  LL_EXTI_Init(&EXTI_InitStruct);

  /**/
  EXTI_InitStruct.Line_0_31 = LL_EXTI_LINE_2;
  EXTI_InitStruct.LineCommand = ENABLE;
  EXTI_InitStruct.Mode = LL_EXTI_MODE_IT;
  EXTI_InitStruct.Trigger = LL_EXTI_TRIGGER_FALLING;
  LL_EXTI_Init(&EXTI_InitStruct);

  /**/
  EXTI_InitStruct.Line_0_31 = LL_EXTI_LINE_3;
  EXTI_InitStruct.LineCommand = ENABLE;
  EXTI_InitStruct.Mode = LL_EXTI_MODE_IT;
  EXTI_InitStruct.Trigger = LL_EXTI_TRIGGER_FALLING;
  LL_EXTI_Init(&EXTI_InitStruct);

  /**/
  EXTI_InitStruct.Line_0_31 = LL_EXTI_LINE_4;
  EXTI_InitStruct.LineCommand = ENABLE;
  EXTI_InitStruct.Mode = LL_EXTI_MODE_IT;
  EXTI_InitStruct.Trigger = LL_EXTI_TRIGGER_FALLING;
  LL_EXTI_Init(&EXTI_InitStruct);

  /**/
  EXTI_InitStruct.Line_0_31 = LL_EXTI_LINE_10;
  EXTI_InitStruct.LineCommand = ENABLE;
  EXTI_InitStruct.Mode = LL_EXTI_MODE_IT;
  EXTI_InitStruct.Trigger = LL_EXTI_TRIGGER_FALLING;
  LL_EXTI_Init(&EXTI_InitStruct);

  /**/
  GPIO_InitStruct.Pin = LL_GPIO_PIN_0 | LL_GPIO_PIN_1;
  GPIO_InitStruct.Mode = LL_GPIO_MODE_OUTPUT;
  GPIO_InitStruct.Speed = LL_GPIO_SPEED_FREQ_LOW;
  GPIO_InitStruct.OutputType = LL_GPIO_OUTPUT_PUSHPULL;
  GPIO_InitStruct.Pull = LL_GPIO_PULL_NO;
  LL_GPIO_Init(GPIOF, &GPIO_InitStruct);
}

/* Radio_Task function */
__weak void Radio_Task(void const * argument)
{

  /* USER CODE BEGIN 5 */
  /* Infinite loop */
  for(;;)
  {
      osDelay(1);
  }
  /* USER CODE END 5 */
}

/* UI_Task function */
__weak void UI_Task(void const * argument)
{
  /* USER CODE BEGIN UI_Task */
  /* Infinite loop */
  for(;;)
  {
    osDelay(1);
  }
  /* USER CODE END UI_Task */
}

/**
  * @brief  Period elapsed callback in non blocking mode
  * @note   This function is called  when TIM14 interrupt took place, inside
  * HAL_TIM_IRQHandler(). It makes a direct call to HAL_IncTick() to increment
  * a global variable "uwTick" used as application time base.
  * @param  htim : TIM handle
  * @retval None
  */
void HAL_TIM_PeriodElapsedCallback(TIM_HandleTypeDef *htim)
{
  if (htim->Instance == TIM14) {
    HAL_IncTick();
  }
}

/**
  * @brief  This function is executed in case of error occurrence.
  * @param  None
  * @retval None
  */
void _Error_Handler(char * file, int line)
{
  /* USER CODE BEGIN Error_Handler_Debug */
  /* User can add his own implementation to report the HAL error return state */
  while(1)
  {
  }
  /* USER CODE END Error_Handler_Debug */
}

#ifdef USE_FULL_ASSERT

/**
   * @brief Reports the name of the source file and the source line number
   * where the assert_param error has occurred.
   * @param file: pointer to the source file name
   * @param line: assert_param error line source number
   * @retval None
   */
void assert_failed(uint8_t* file, uint32_t line)
{
  /* USER CODE BEGIN 6 */
  /* User can add his own implementation to report the file name and line number,
    ex: printf("Wrong parameters value: file %s on line %d\r\n", file, line) */
  /* USER CODE END 6 */

}

#endif

/**
  * @}
  */

/**
  * @}
*/

/************************ (C) COPYRIGHT STMicroelectronics *****END OF FILE****/
