AlexanderEkb/Alarm/FOB/SW/FOB_3/Keyfob/Keyfob.ioc

Mcu.UserName=STM32F051K8Ux
PA0.Signal=GPXTI0
PA1.Signal=GPXTI1
PA10.Signal=GPXTI10
PA13.Signal=SYS_SWDIO
PA14.Signal=SYS_SWCLK
PA2.Signal=GPXTI2
PA3.Signal=GPXTI3
PA4.Signal=GPXTI4
PA5.Signal=SPI1_SCK
PA6.Signal=SPI1_MISO
PA7.Signal=SPI1_MOSI
PA8.Signal=S_TIM1_CH1
PA9.Signal=S_TIM1_CH2
PB0.Signal=GPIO_Output
PB1.Signal=GPIO_Output
PB6.Signal=I2C1_SCL
PB7.Signal=I2C1_SDA
