AlexanderEkb/Alarm/(commit log)

2018-02-18 initial project state
    [1-FOB.SchDoc, 2-MCU.SchDoc, 3-Display.SchDoc, 5-Btn and beeper.SchDoc, 5-Radio.SchDoc, 6-Power.SchDoc, Bill of Materials-FOB(3).xls, Bill of Materials-Сигнализация.xls]
2018-02-18 Engine start sequence was refactored.
    Now it's needed to make Measurements module to produce events when RPM and voltage become greater then threshold.
2018-03-03 3D Models for the FOB
    [Top.step]
